piriram/stm32-imu-telemetry/Core/Src/main.c

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
/* Includes ------------------------------------------------------------------*/
#include "main.h"

/* USER CODE BEGIN Includes */
#include <stdio.h>
#include "can_node.h"
#include "mpu6050.h"
#include "telemetry.h"
#include "uart_console.h"
/* USER CODE END Includes */

I2C_HandleTypeDef hi2c1;

UART_HandleTypeDef huart1;

/* USER CODE BEGIN PV */
MPU6050_t my_mpu;

Node_Status_t g_sensor_status = NODE_OK;
uint32_t last_sensor_tick = 0;
uint32_t last_telemetry_tick = 0;
uint32_t last_probe_tick = 0;
/* USER CODE END PV */
 
void SystemClock_Config(void);
static void MX_GPIO_Init(void);
static void MX_USART1_UART_Init(void);
static void MX_I2C1_Init(void);
/* USER CODE BEGIN 0 */
static HAL_StatusTypeDef I2C1_RecoverPeripheral(void)
{
  /*
   * A cable disconnect can leave the STM32F1 I2C peripheral with BUSY/START
   * state latched even after the signal is restored. DeInit/Init applies the
   * peripheral software reset and restores PB6/PB7 before probing WHO_AM_I.
   */
  if (HAL_I2C_DeInit(&hi2c1) != HAL_OK)
  {
    return HAL_ERROR;
  }

  MX_I2C1_Init();
  return HAL_OK;
}

/*
 * [공부 포인트 - printf 리다이렉션 (Redirection)]
 * C언어의 표준 출력 함수인 printf()는 원래 PC의 모니터(콘솔)로 문자를 보냅니다.
 * 임베디드 보드에는 모니터가 없으므로, 이 마법의 함수(__io_putchar)를 오버라이딩하여
 * printf()가 호출될 때마다 그 글자(ch)들을 UART1 통신선(Tx)을 통해 PC로 전송하도록 방향을 틀어줍니다.
 */
int __io_putchar(int ch)
{
  HAL_UART_Transmit(&huart1, (uint8_t *)&ch, 1, 0xFFFF);
  return ch;
}
/* USER CODE END 0 */

/**
  * @brief  The application entry point.
  * @retval int
  */
int main(void)
{

  /* MCU Configuration--------------------------------------------------------*/

  /* Reset of all peripherals, Initializes the Flash interface and the Systick. */
  HAL_Init();

  /* Configure the system clock */
  SystemClock_Config();

  /* Initialize all configured peripherals */
  MX_GPIO_Init();
  MX_USART1_UART_Init();
  MX_I2C1_Init();
  /* USER CODE BEGIN 2 */
  UART_Console_Init(&huart1);
  Telemetry_Init();

  if (CAN_Node_Init(&huart1)) {
      Telemetry_Publish_String(&huart1, "BOOT,OK,CAN_500K_READY\r\n");
  } else {
      Telemetry_Publish_String(&huart1, "BOOT,ERR,CAN_INIT_FAILED\r\n");
  }
  
  // --- [DIAGNOSTIC] I2C Scanner ---
  char scan_buf[64];
  uint8_t found_count = 0;
  Telemetry_Publish_String(&huart1, "BOOT,INFO,SCANNING_I2C_BUS...\r\n");
  for(uint16_t i=1; i<128; i++) {
      if(HAL_I2C_IsDeviceReady(&hi2c1, (i<<1), 3, 100) == HAL_OK) {
          uint8_t whoami = 0;
          HAL_I2C_Mem_Read(&hi2c1, (i<<1), 0x75, 1, &whoami, 1, 100);
          snprintf(scan_buf, sizeof(scan_buf), "BOOT,INFO,FOUND_I2C_AT_0x%02X_WHOAMI_0x%02X\r\n", i, whoami);
          Telemetry_Publish_String(&huart1, scan_buf);
          found_count++;
      }
  }
  if(found_count == 0) {
      Telemetry_Publish_String(&huart1, "BOOT,ERR,NO_I2C_DEVICES_FOUND\r\n");
  }
  // --------------------------------
  
  if (MPU6050_Init(&hi2c1, &my_mpu) != MPU6050_OK) {
      g_sensor_status = NODE_SENSOR_OFFLINE;
      Telemetry_Publish_String(&huart1, "BOOT,ERR,DEVICE_NOT_FOUND\r\n");
  } else {
      g_sensor_status = NODE_OK;
      Telemetry_Publish_String(&huart1, "BOOT,OK,MPU6050_FOUND\r\n");
  }
  
  last_sensor_tick = HAL_GetTick();
  last_telemetry_tick = HAL_GetTick();
  last_probe_tick = HAL_GetTick();
  /* USER CODE END 2 */

  /* Infinite loop */
  /* USER CODE BEGIN WHILE */
  while (1)
  {
      uint32_t current_tick = HAL_GetTick();
      
      // 1. Process UART commands
      UART_Console_Process();

      // 2. Process CAN frames deferred from the RX FIFO ISR
      CAN_Node_Process();

      // 3. Sensor Sampling (20Hz = 50ms)
      if (g_sensor_status == NODE_OK) {
          if ((current_tick - last_sensor_tick) >= 50) {
              last_sensor_tick = current_tick;
              
              if (MPU6050_Read_All(&hi2c1, &my_mpu) != MPU6050_OK) {
                  g_sensor_status = NODE_SENSOR_OFFLINE;
                  Telemetry_Publish_String(&huart1, "ERR,SENSOR_OFFLINE\r\n");
                  last_probe_tick = current_tick;
              }
          }
      } 
      // 4. Sensor Reconnect Probe (1Hz = 1000ms)
      else if (g_sensor_status == NODE_SENSOR_OFFLINE) {
          if ((current_tick - last_probe_tick) >= 1000) {
              last_probe_tick = current_tick;

              if ((I2C1_RecoverPeripheral() == HAL_OK) &&
                  (MPU6050_Init(&hi2c1, &my_mpu) == MPU6050_OK)) {
                  g_sensor_status = NODE_OK;
                  Telemetry_Publish_String(&huart1, "OK,SENSOR_RECOVERED\r\n");
              }
          }
      }
      
      // 5. UART/CAN Publishing (10Hz = 100ms)
      if ((current_tick - last_telemetry_tick) >= 100) {
          last_telemetry_tick = current_tick;

          IMU_Sample_t sample;
          sample.ax = my_mpu.Accel_X_Raw;
          sample.ay = my_mpu.Accel_Y_Raw;
          sample.az = my_mpu.Accel_Z_Raw;
          sample.gx = my_mpu.Gyro_X_Raw;
          sample.gy = my_mpu.Gyro_Y_Raw;
          sample.gz = my_mpu.Gyro_Z_Raw;
          sample.roll_cdeg = (int16_t)(my_mpu.Filtered_Roll * 100.0);
          sample.pitch_cdeg = (int16_t)(my_mpu.Filtered_Pitch * 100.0);
          sample.t_ms = current_tick;
          sample.status = g_sensor_status;

          if (g_sensor_status == NODE_OK) {
              Telemetry_Publish(&huart1, &sample);
          }

          (void)CAN_Node_PublishIMU(&sample);

          // Heartbeat LED
          HAL_GPIO_TogglePin(GPIOC, GPIO_PIN_13);
      }
      
    /* USER CODE END WHILE */

    /* USER CODE BEGIN 3 */
  }
  /* USER CODE END 3 */
}

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
