piriram/stm32-imu-telemetry/(commit log)

2026-07-28 init: STM32F103 MPU6050 I2C + 상보필터 구현 (Phase 1~3 완료)
2026-08-07 docs: focus README on IMU attitude estimation
2026-08-07 refactor: replace firmware with complementary filter IMU node
    - Add telemetry module (CSV stream over UART, sequence number, stream on/off control)
    - Add UART console with ring buffer RX and interrupt-driven command processing
    - Add sensor offline detection and auto-reconnect state machine
    - Implement non-blocking multi-task scheduling via HAL_GetTick()
    - Update README (Korean) with full protocol docs and implementation notes
    [main.c, mpu6050.c, mpu6050.h, telemetry.c, telemetry.h, uart_console.c, uart_console.h]
2026-08-07 feat: UART 비동기 인터페이스 및 I2C 클론칩(0x72) 대응 완벽 구현
    - MPU6050 클론 칩(0x72) 호환성 Whitelist 추가
    - USART1 NVIC IRQ Enable 누락 수정으로 비동기 통신 정상화
    - 10Hz CSV Telemetry 및 stream 제어 최종 성공
    [analyze_uart_log.py, main.c, mpu6050.c, read_uart.py, run_uart_tests.py, uart_listener.py]
2026-08-08 docs: document simultaneous ST-Link and UART USB setup
2026-08-08 feat: validate UART diagnostics and sensor recovery
2026-08-08 docs: add public sensor recovery evidence
2026-08-08 docs: consolidate UART milestone evidence
